EvilOtter222/pcb-project/BOM.md

# RP2040 Chip – bill of materials

<!-- Generated by Half Life from project cmuyvhloc01nu01rwjo6lsv70. Edits here are overwritten on the next sync. -->
<!-- Generated: 2026-10-12T03:27:44.305Z -->

> [!NOTE]
> This parts list is mirrored from [Half Life](https://halflife.hackclub.com). Editing it here will not change the platform's copy, and the next sync overwrites this file.

| Week | Tier | Parts funding |
| --- | --- | --- |
| Week 1 | Tier 2 | $65.00 |

| Part | What it's for | Qty | Unit | Total | Vendor |
| --- | --- | --- | --- | --- | --- |
| [RP2040 microcontroller](https://lcsc.com/product-detail/C2040.html) | Main chip that runs the games and reads the buttons | 1 | $1.00 | $1.00 | [LCSC](https://lcsc.com/product-detail/C2040.html) |
| [W25Q128JVSIQ flash memory](https://lcsc.com/product-detail/C113767.html) | Stores the firmware and games | 1 | $2.52 | $2.52 | [LCSC](https://lcsc.com/product-detail/C113767.html) |
| [AP2112K-3.3 regulator (pack of 5)](https://lcsc.com/product-detail/C51118.html) | Turns 5V from USB into 3.3V | 1 | $0.86 | $0.86 | [LCSC](https://lcsc.com/product-detail/C51118.html) |
| [ABM8-272-T3 12 MHz crystal](https://lcsc.com/product-detail/C20625731.html) | Clock for the RP2040 | 1 | $0.63 | $0.63 | [LCSC](https://lcsc.com/product-detail/C20625731.html) |
| [TYPE-C-31-M-12 USB-C port (pack of 5)](https://lcsc.com/product-detail/C165948.html) | Power and programming | 1 | $0.86 | $0.86 | [LCSC](https://lcsc.com/product-detail/C165948.html) |
| [PAM8302AADCR audio amplifier](https://www.lcsc.com/product-detail/C112137.html) | Drives the speaker | 1 | $0.62 | $0.62 | [LCSC](https://www.lcsc.com/product-detail/C112137.html) |
| [5 pin connector](https://www.lcsc.com/product-detail/C5378715.html) | Plugs in the display’s ribbon cable | 1 | $3.52 | $3.52 | [LCSC](https://www.lcsc.com/product-detail/C5378715.html) |
| [ER-TFT020-3 2.0 inch IPS display](https://buydisplay.com/2-inch-240x320-ips-tft-lcd-display-with-connector-fpc) | The screen | 1 | $4.38 | $4.38 | [BuyDisplay](https://buydisplay.com/2-inch-240x320-ips-tft-lcd-display-with-connector-fpc) |
| [JST B2B-PH-K-S header (pack of 20)](https://lcsc.com/product-detail/C131337.html) | Socket for the speaker plug | 1 | $0.71 | $0.71 | [LCSC](https://lcsc.com/product-detail/C131337.html) |
| [Pin header 1x40 (pack of 5)](https://lcsc.com/product-detail/C2337.html) | Debug and expansion headers | 1 | $0.80 | $0.80 | [LCSC](https://lcsc.com/product-detail/C2337.html) |
| [Tactile switch 6x6x5 mm (pack of 10)](https://lcsc.com/product-detail/C110153.html) | 8 game buttons plus boot and reset | 1 | $0.55 | $0.55 | [LCSC](https://lcsc.com/product-detail/C110153.html) |
| [Passives: 0603/0805 resistors and capacitors, MMBT2222A transistor](https://lcsc.com) | Decoupling, pull-downs, USB resistors, audio filter, backlight switch | 1 | $6.58 | $6.58 | [LCSC](https://lcsc.com) |
| [Custom PCB (5 boards)](https://jlcpcb.com) | The circuit board everything is soldered to | 1 | $7.20 | $7.20 | [JLCPCB](https://jlcpcb.com) |
| [Analog thumbstick (already owned)](https://github.com/EvilOtter222/pcb-project) | Direction input for games | 1 | $0.01 | $0.01 | [Home](https://github.com/EvilOtter222/pcb-project) |
| [Small speaker (already owned)](https://github.com/EvilOtter222/pcb-project) | Game sound | 1 | $0.01 | $0.01 | [Home](https://github.com/EvilOtter222/pcb-project) |
| **Parts subtotal** | — | — | — | **$30.25** | — |
| **Tax & shipping** | — | — | — | **$27.70** | — |
| **Total** | — | — | — | **$57.95** | — |

$7.05 left of the tier's funding.
