EvilOtter222/pcb-project/(list of files, drawings)

Other design files:
pcb-project.dsn
