EvilOtter222/pcb-project/pcb-project.kicad_pcb

## KiCad design pcb-project.kicad_pcb (2026-10-12)

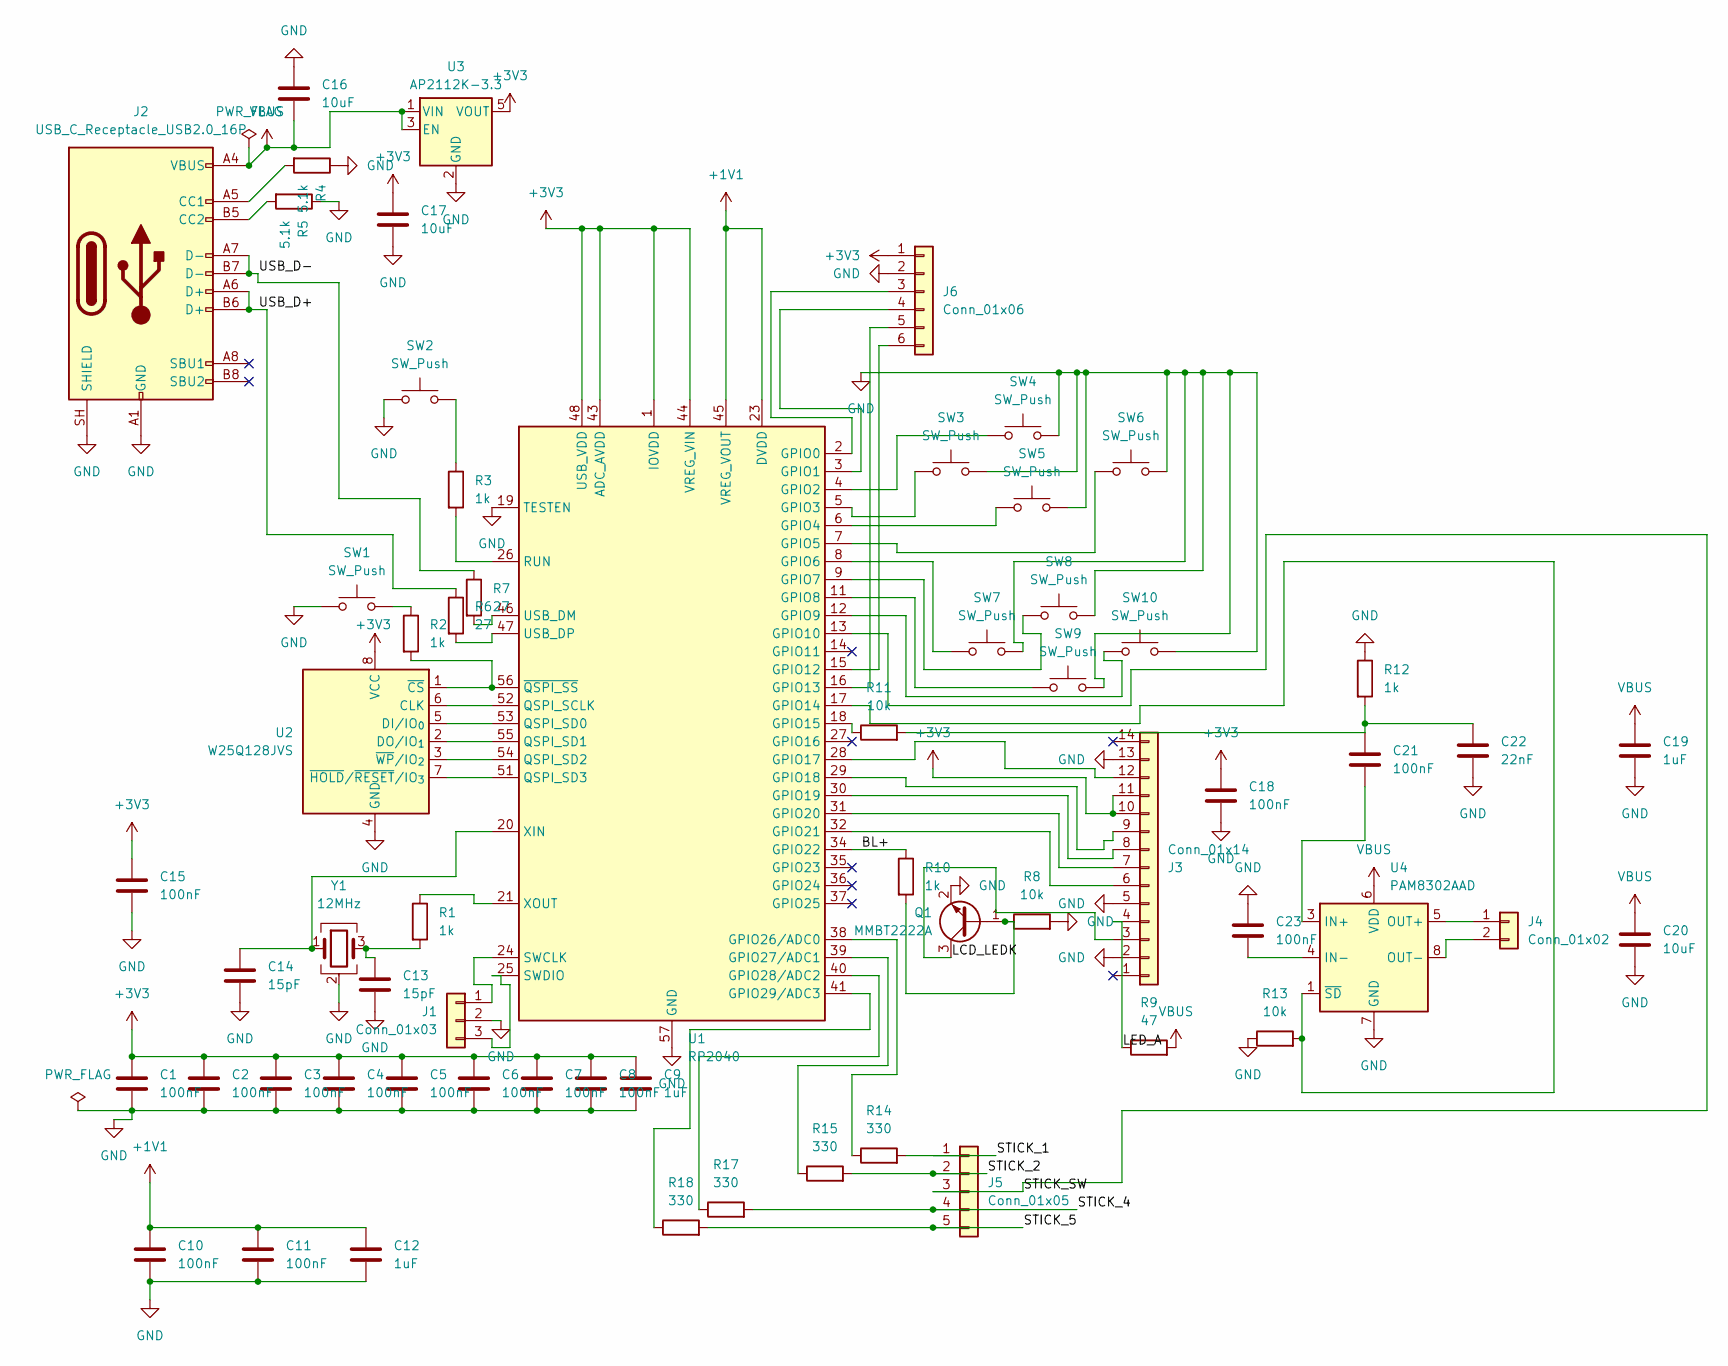
[picture p5: schematic pcb-project.kicad_sch]

Parts:
C1, C2, C3, C4, C5, C6, C7, C8, C10, C11, C15, C18, C21, C23: 100nF; C_0603_1608Metric
C9, C12, C19: 1uF; C_0603_1608Metric
C13, C14: 15pF; C_0603_1608Metric
C16, C17, C20: 10uF; C_0805_2012Metric
C22: 22nF; C_0603_1608Metric
J1: Conn_01x03; PinHeader_1x03_P2.54mm_Vertical
J2: USB_C_Receptacle_USB2.0_16P; USB_C_Receptacle_HRO_TYPE-C-31-M-12
J3: Conn_01x14; Hirose_FH12-14S-0.5SH_1x14-1MP_P0.50mm_Horizontal
J4: Conn_01x02; JST_PH_B2B-PH-K_1x02_P2.00mm_Vertical
J5: Conn_01x05; TE_0-1734839-5_1x05-1MP_P0.5mm_Horizontal
J6: Conn_01x06; PinHeader_1x06_P2.54mm_Vertical
Q1: MMBT2222A; SOT-23
R1, R2, R3, R10, R12: 1k; R_0603_1608Metric
R4, R5: 5.1k; R_0603_1608Metric
R6, R7: 27; R_0603_1608Metric
R8, R11, R13: 10k; R_0603_1608Metric
R9: 47; R_0805_2012Metric
R14, R15, R17, R18: 330; R_0603_1608Metric
SW1, SW2, SW3, SW4, SW5, SW6, SW7, SW8, SW9, SW10: SW_Push; SW_PUSH_6mm
U1: RP2040; QFN-56-1EP_7x7mm_P0.4mm_EP3.2x3.2mm
U2: W25Q128JVS; SOIC-8_5.3x5.3mm_P1.27mm
U3: AP2112K-3.3; SOT-23-5
U4: PAM8302AAD; SOIC-8_3.9x4.9mm_P1.27mm
Y1: 12MHz; Crystal_SMD_Abracon_ABM8G-4Pin_3.2x2.5mm

Connections:
+1V1: C10.1, C11.1, C12.1, U1.23 (DVDD), U1.45 (VREG_VOUT), U1.50 (DVDD)
+3V3: C1.1, C2.1, C3.1, C4.1, C5.1, C6.1, C7.1, C8.1, C9.1, C15.1, C17.1, C18.1, J3.10, J3.11, J6.1, U1.1 (IOVDD), U1.10 (IOVDD), U1.22 (IOVDD), U1.33 (IOVDD), U1.42 (IOVDD), U1.43 (ADC_AVDD), U1.44 (VREG_VIN), U1.48 (USB_VDD), U1.49 (IOVDD), U2.8 (VCC), U3.5 (VOUT)
/BL+: R10.1, U1.34 (GPIO22)
/LCD_LEDK: J3.3, Q1.3 (C)
/LED_A: J3.4, R9.1
/STICK_1: J5.1, R14.2
/STICK_2: J5.2, R15.2
/STICK_4: J5.4, R17.2
/STICK_5: J5.5, R18.2
/STICK_SW: J5.3, U1.13 (GPIO10)
/USB_D+: J2.A6 (D+), J2.B6 (D+), R6.1
/USB_D-: J2.A7 (D-), J2.B7 (D-), R7.1
GND: C1.2, C2.2, C3.2, C4.2, C5.2, C6.2, C7.2, C8.2, C9.2, C10.2, C11.2, C12.2, C13.2, C14.2, C15.2, C16.1, C17.2, C18.2, C19.2, C20.2, C22.2, C23.2, J1.2, J2.A1 (GND), J2.A12 (GND), J2.B1 (GND), J2.B12 (GND), J2.SH (SHIELD), J3.2, J3.5, J3.13, J6.2, Q1.2 (E), R4.1, R5.1, R8.2, R12.1, R13.1, SW1.1, SW2.1, SW3.2, SW4.2, SW5.2, SW6.2, SW7.2, SW8.2, SW9.2, SW10.2, U1.19 (TESTEN), U1.57 (GND), U2.4 (GND), U3.2 (GND), U4.7 (GND), Y1.2 (G), Y1.4 (G)
unnamed: C13.1, R1.2, Y1.3
unnamed: C21.1, C22.1, R11.2, R12.2
unnamed: J1.1, U1.24 (SWCLK)
unnamed: J1.3, U1.25 (SWDIO)
unnamed: J2.A5 (CC1), R4.2
unnamed: J2.B5 (CC2), R5.2
unnamed: J3.6, U1.32 (GPIO21)
unnamed: J3.7, U1.31 (GPIO20)
unnamed: J3.8, U1.30 (GPIO19)
unnamed: J3.9, U1.29 (GPIO18)
unnamed: J3.12, U1.28 (GPIO17)
unnamed: J4.1, U4.5 (OUT+)
unnamed: J4.2, U4.8 (OUT-)
unnamed: J6.3, U1.2 (GPIO0)
unnamed: J6.4, U1.3 (GPIO1)
unnamed: J6.5, U1.16 (GPIO13)
unnamed: J6.6, U1.15 (GPIO12)
unnamed: Q1.1 (B), R8.1, R10.2
unnamed: R2.1, SW1.2
unnamed: R3.1, SW2.2
unnamed: SW4.1, U1.4 (GPIO2)
unnamed: SW3.1, U1.5 (GPIO3)
unnamed: SW5.1, U1.6 (GPIO4)
unnamed: SW6.1, U1.7 (GPIO5)
unnamed: SW7.1, U1.8 (GPIO6)
unnamed: SW8.1, U1.9 (GPIO7)
unnamed: SW9.1, U1.11 (GPIO8)
unnamed: SW10.1, U1.12 (GPIO9)
unnamed: R13.2, U1.17 (GPIO14), U4.1 (~SD)
unnamed: R11.1, U1.18 (GPIO15)
unnamed: R14.1, U1.38 (GPIO26/ADC0)
unnamed: R15.1, U1.39 (GPIO27/ADC1)
unnamed: R17.1, U1.40 (GPIO28/ADC2)
unnamed: R18.1, U1.41 (GPIO29/ADC3)
unnamed: U1.52 (QSPI_SCLK), U2.6 (CLK)
unnamed: U1.53 (QSPI_SD0), U2.5 (DI/IO_{0})
unnamed: U1.55 (QSPI_SD1), U2.2 (DO/IO_{1})
unnamed: U1.54 (QSPI_SD2), U2.3 (~WP/IO_{2})
unnamed: U1.51 (QSPI_SD3), U2.7 (~HOLD/~RESET/IO_{3})
unnamed: R3.2, U1.26 (RUN)
unnamed: R7.2, U1.46 (USB_DM)
unnamed: R6.2, U1.47 (USB_DP)
unnamed: C14.1, U1.20 (XIN), Y1.1
unnamed: R1.1, U1.21 (XOUT)
unnamed: R2.2, U1.56 (~QSPI_SS), U2.1 (~CS)
unnamed: C21.2, U4.3 (IN+)
unnamed: C23.1, U4.4 (IN-)
VBUS: C16.2, C19.1, C20.1, J2.A4 (VBUS), J2.A9 (VBUS), J2.B4 (VBUS), J2.B9 (VBUS), R9.2, U3.1 (VIN), U3.3 (EN), U4.6 (VDD)

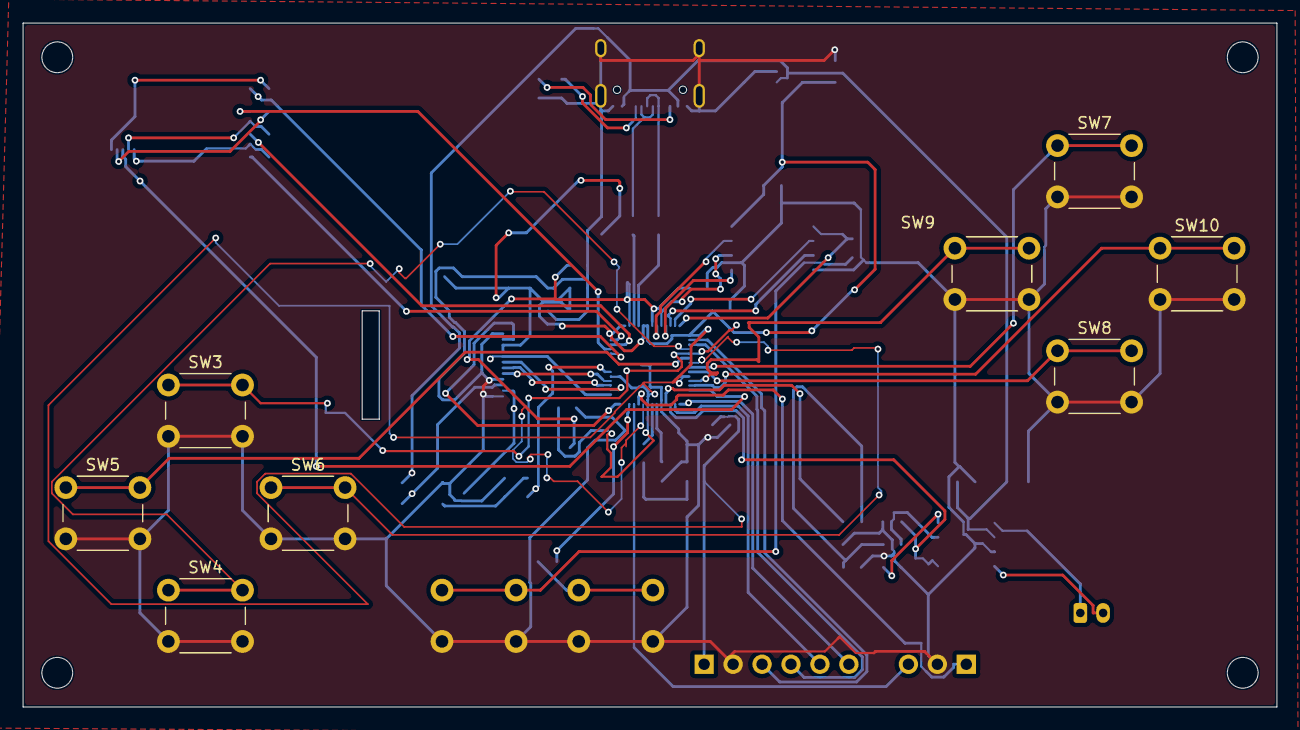
[picture p6: board pcb-project.kicad_pcb from above]

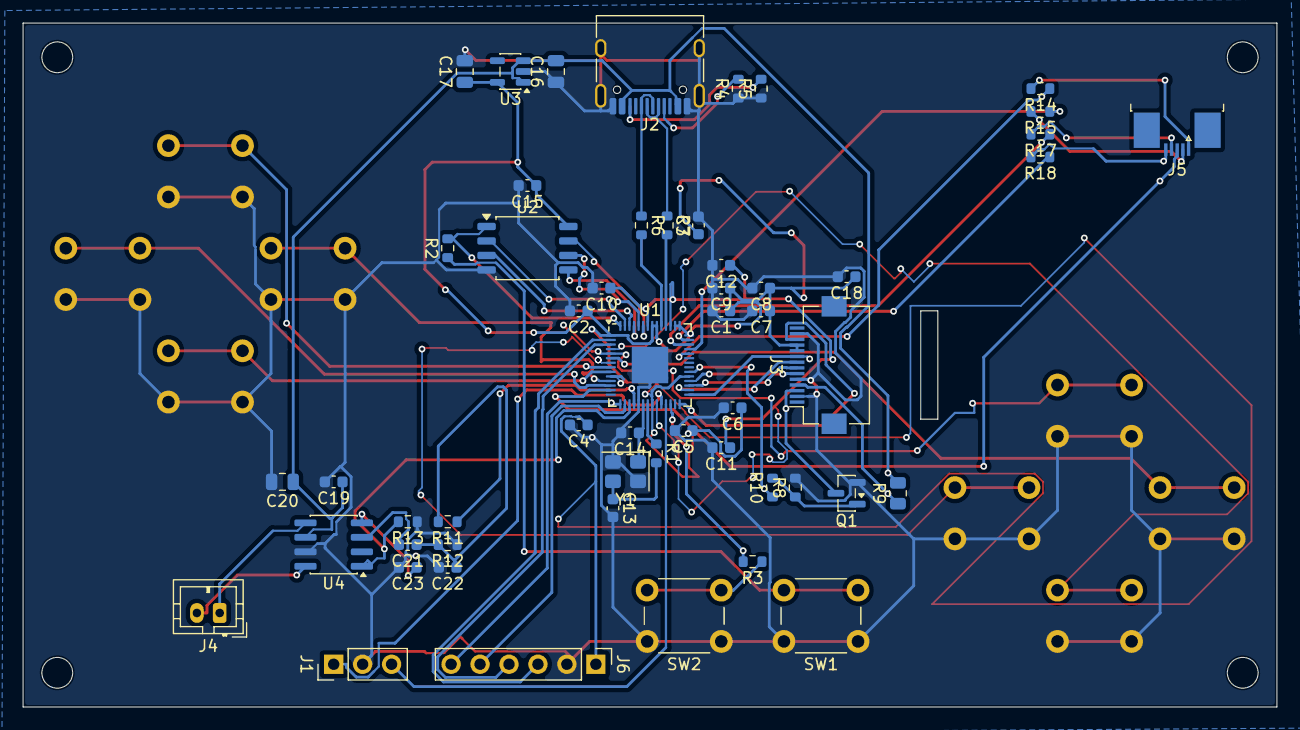
[picture p7: board pcb-project.kicad_pcb from below]

Board: 2 copper layers, 110.0 x 60.0 mm, 62 parts (54 on the bottom side), 61 nets.
