EvilOtter222/pcb-project/(commit log)

2026-10-10 Schematic complete, ERC clean, footprints assigned
    [pcb-project.kicad_pcb, pcb-project.kicad_sch]
2026-10-11 Just started PCB designing, imported schematic, rearranging right now
    [pcb-project.kicad_pcb]
2026-10-11 Started arranging components, will continue tomorrow
    [pcb-project.kicad_pcb]
2026-10-11 Board outline and placement done
    [pcb-project.kicad_pcb]
2026-10-11 Crystal routed, RP2040 orientation fixed
    [pcb-project.kicad_pcb]
2026-10-11 Crystal and USB hand-routed, before autoroute
    [pcb-project.kicad_pcb]
2026-10-11 Cutouts added, hand-routed traces locked
    [pcb-project.kicad_pcb]
2026-10-11 handrouted wires, 14 unrouted
    [pcb-project.dsn, pcb-project.kicad_pcb]
2026-10-11 handrouted wires, 0 unrouted!!
    [pcb-project.kicad_pcb]
2026-10-12 Add board pictures, gerbers and final layout
    [pcb-project-B_Cu.gbl, pcb-project-B_Mask.gbs, pcb-project-B_Paste.gbp, pcb-project-B_Silkscreen.gbo, pcb-project-Edge_Cuts.gm1, pcb-project-F_Cu.gtl, pcb-project-F_Mask.gts, pcb-project-F_Paste.gtp]
2026-10-12 Replace 3D front image with schematic in README
    Updated the image in the README to show the schematic instead of the 3D front view.
2026-10-12 Change schematic image to PCB layout in README
    Updated image reference in README from schematic to PCB layout.
2026-10-12 Add README, firmware, gerbers, BOM and pictures
2026-10-12 add bom csv
    [bom.csv]
2026-10-12 Final BOM update
    [bom.csv]
2026-10-12 Rename project to 'RP2040 Switch Inspired Console'
